abzman/1979-TI-thermostat-replacement-PCB/README.md

# 1979-TI-thermostat-replacement-PCB
replaces the PCB in an old thermostat with one that has an esp32 onboard and other upgrades
