abzman/1979-TI-thermostat-replacement-PCB/Board/TI thermostat esp32/TI thermostat esp32.kicad_pcb

## KiCad design Board/TI thermostat esp32/TI thermostat esp32.kicad_pcb (2022-02-09)

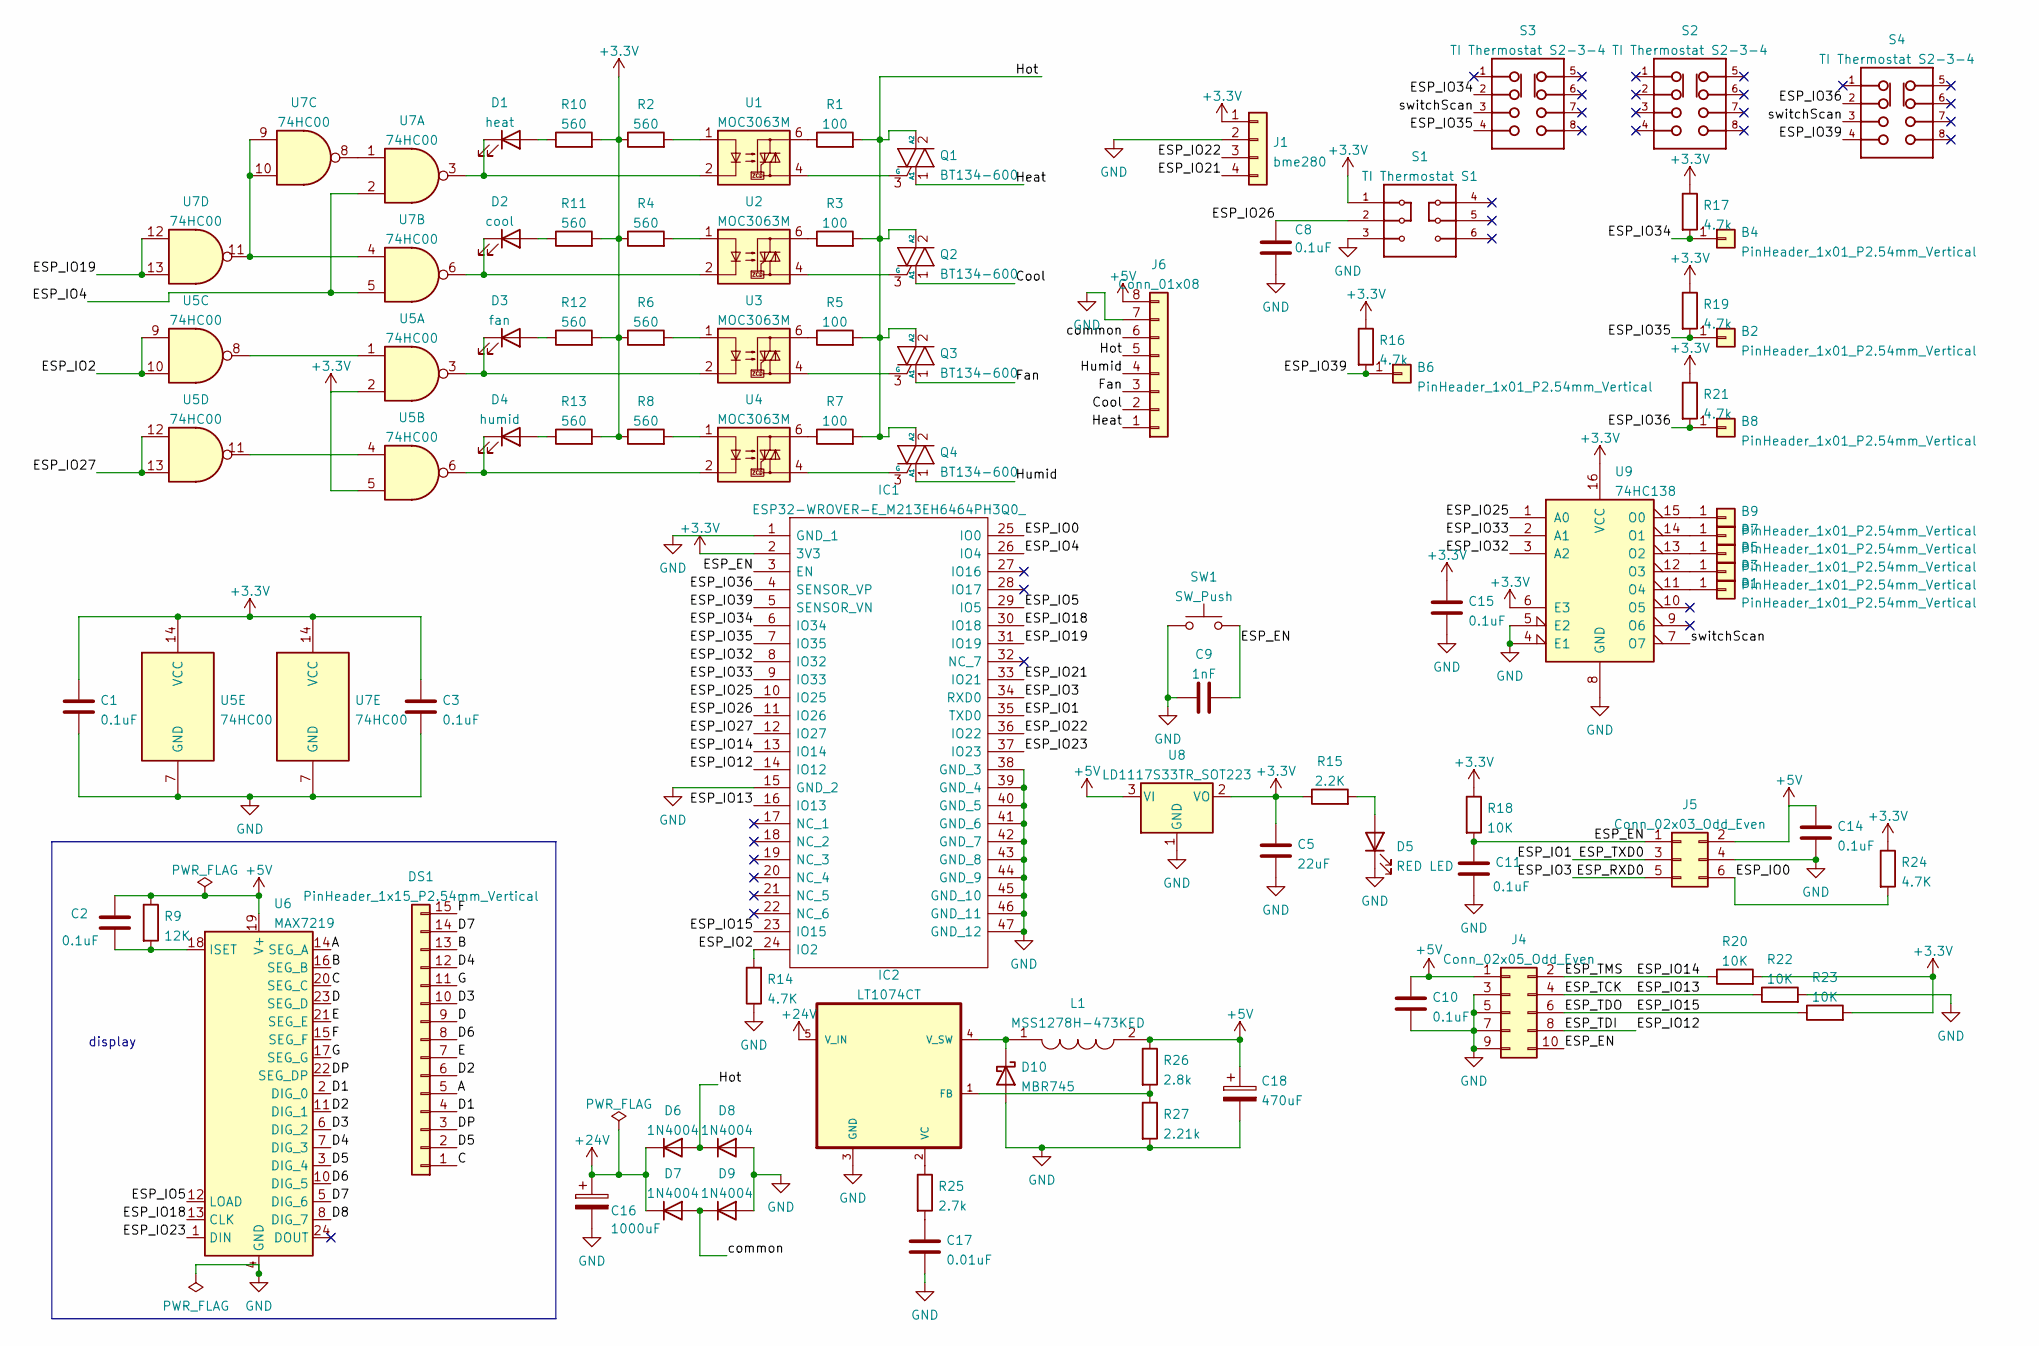
[picture p1: schematic TI thermostat esp32.kicad_sch]

Parts:
B1, B2, B3, B4, B5, B6, B7, B8, B9: PinHeader_1x01_P2.54mm_Vertical
C1, C2, C3, C8, C10, C11, C14, C15: 0.1uF; C_0603_1608Metric
C5: 22uF; CP_Radial_D5.0mm_P2.00mm
C9: 1nF; C_0603_1608Metric
C16: 1000uF; CP_Radial_D7.5mm_P2.50mm
C17: 0.01uF; C_0603_1608Metric
C18: 470uF; CP_Radial_D7.5mm_P2.50mm
D1: heat; LED_0603_1608Metric
D2: cool; LED_0603_1608Metric
D3: fan; LED_0603_1608Metric
D4: humid; LED_0603_1608Metric
D5: RED LED; LED_0603_1608Metric
D6, D7, D8, D9: 1N4004; D_SMA
D10: MBR745; TO-220-2_Horizontal_TabUp
DS1: PinHeader_1x15_P2.54mm_Vertical
IC1: ESP32-WROVER-E_M213EH6464PH3Q0_; ESP32WROVEREM213EH6464PH3Q0; Mouser Part Number 356-ESP32WRVE26464PC
IC2: LT1074CT; TO220_5L
J1: bme280; PinHeader_1x04_P2.54mm_Vertical
J4: Conn_02x05_Odd_Even; PinHeader_2x05_P2.54mm_Horizontal
J5: Conn_02x03_Odd_Even; PinHeader_2x03_P2.54mm_Horizontal
J6: Conn_01x08; PhoenixContact_MC_1,5_8-G-3.81_1x08_P3.81mm_Horizontal
L1: MSS1278H-473KED; INDPM120120X805N; Mouser Part Number 994-MSS1278H-473KED
Q1, Q2, Q3, Q4: BT134-600; TO-126-3_Horizontal_TabDown
R1, R3, R5, R7: 100; R_0603_1608Metric
R2, R4, R6, R8, R10, R11, R12, R13: 560; R_0603_1608Metric
R9: 12K; R_0603_1608Metric
R14, R24: 4.7K; R_0603_1608Metric
R15: 2.2K; R_0603_1608Metric
R16, R17, R19, R21: 4.7k; R_0603_1608Metric
R18, R20, R22, R23: 10K; R_0603_1608Metric
R25: 2.7k; R_0603_1608Metric
R26: 2.8k; R_0603_1608Metric
R27: 2.21k; R_0603_1608Metric
S1: TI Thermostat S1
S2, S3, S4: TI Thermostat S2-3-4
SW1: SW_Push; SW_Tactile_SPST_Angled_PTS645Vx39-2LFS
U1, U2, U3, U4: MOC3063M; DIP-6_W7.62mm
U5, U7: 74HC00; SOIC-14_3.9x8.7mm_P1.27mm
U6: MAX7219; SOP-24_7.5x15.4mm_P1.27mm
U8: LD1117S33TR_SOT223; SOT-223-3_TabPin2
U9: 74HC138; SOIC-16_3.9x9.9mm_P1.27mm

Connections:
+3V3: C1.1, C3.1, C5.1, C15.1, IC1.2 (3V3), J1.1, R2.1, R4.1, R6.1, R8.1, R10.2, R11.2, R12.2, R13.2, R15.1, R16.1, R17.1, R18.1, R19.1, R20.2, R21.1, R23.2, R24.1, S1.1, U5.2, U5.5, U5.14 (VCC), U7.14 (VCC), U8.2 (VO), U9.6 (E3), U9.16 (VCC)
+5V: C2.1, C10.1, C14.1, C18.1, J4.1, J5.2, J6.8, L1.2, R9.1, R26.1, U6.19 (V+), U8.3 (VI)
+24V: C16.1, D6.1 (K), D7.1 (K), IC2.5 (V_IN)
/A: DS1.5, U6.14 (SEG_A)
/B: DS1.13, U6.16 (SEG_B)
/C: DS1.1, U6.20 (SEG_C)
/Cool: J6.2, Q2.1 (A1)
/D: DS1.9, U6.23 (SEG_D)
/D1: DS1.4, U6.2 (DIG_0)
/D2: DS1.6, U6.11 (DIG_1)
/D3: DS1.10, U6.6 (DIG_2)
/D4: DS1.12, U6.7 (DIG_3)
/D5: DS1.2, U6.3 (DIG_4)
/D6: DS1.8, U6.10 (DIG_5)
/D7: DS1.14, U6.5 (DIG_6)
/D8: U6.8 (DIG_7)
/DP: DS1.3, U6.22 (SEG_DP)
/E: DS1.7, U6.21 (SEG_E)
/ESP_EN: C9.2, C11.1, IC1.3 (EN), J4.10, J5.1, R18.2, SW1.2
/ESP_IO0: IC1.25 (IO0), J5.6, R24.2
/ESP_IO1: IC1.35 (TXD0), J5.3
/ESP_IO2: IC1.24 (IO2), R14.2, U5.9, U5.10
/ESP_IO3: IC1.34 (RXD0), J5.5
/ESP_IO4: IC1.26 (IO4), U7.2, U7.5
/ESP_IO5: IC1.29 (IO5), U6.12 (LOAD)
/ESP_IO12: IC1.14 (IO12), J4.8
/ESP_IO13: IC1.16 (IO13), J4.4, R22.1
/ESP_IO14: IC1.13 (IO14), J4.2, R20.1
/ESP_IO15: IC1.23 (IO15), J4.6, R23.1
/ESP_IO18: IC1.30 (IO18), U6.13 (CLK)
/ESP_IO19: IC1.31 (IO19), U7.12, U7.13
/ESP_IO21: IC1.33 (IO21), J1.4
/ESP_IO22: IC1.36 (IO22), J1.3
/ESP_IO23: IC1.37 (IO23), U6.1 (DIN)
/ESP_IO25: IC1.10 (IO25), U9.1 (A0)
/ESP_IO26: C8.1, IC1.11 (IO26), S1.2
/ESP_IO27: IC1.12 (IO27), U5.12, U5.13
/ESP_IO32: IC1.8 (IO32), U9.3 (A2)
/ESP_IO33: IC1.9 (IO33), U9.2 (A1)
/ESP_IO34: B4.1, IC1.6 (IO34), R17.2, S3.2
/ESP_IO35: B2.1, IC1.7 (IO35), R19.2, S3.4
/ESP_IO36: B8.1, IC1.4 (SENSOR_VP), R21.2, S4.2
/ESP_IO39: B6.1, IC1.5 (SENSOR_VN), R16.2, S4.4
/F: DS1.15, U6.15 (SEG_F)
/Fan: J6.3, Q3.1 (A1)
/G: DS1.11, U6.17 (SEG_G)
/Heat: J6.1, Q1.1 (A1)
/Hot: D6.2 (A), D8.1 (K), J6.5, Q1.2 (A2), Q2.2 (A2), Q3.2 (A2), Q4.2 (A2), R1.2, R3.2, R5.2, R7.2
/Humid: J6.4, Q4.1 (A1)
/common: D7.2 (A), D9.1 (K), J6.6
/switchScan: S3.3, S4.3, U9.7 (O7)
GND: C1.2, C3.2, C5.2, C8.2, C9.1, C10.2, C11.2, C14.2, C15.2, C16.2, C17.2, C18.2, D5.1 (K), D8.2 (A), D9.2 (A), D10.2 (A), IC1.1 (GND_1), IC1.15 (GND_2), IC1.38 (GND_3), IC1.39 (GND_4), IC1.40 (GND_5), IC1.41 (GND_6), IC1.42 (GND_7), IC1.43 (GND_8), IC1.44 (GND_9), IC1.45 (GND_10), IC1.46 (GND_11), IC1.47 (GND_12), IC2.3 (GND), J1.2, J4.3, J4.5, J4.7, J4.9, J5.4, J6.7, R14.1, R22.2, R27.2, S1.3, SW1.1, U5.7 (GND), U6.4 (GND), U6.9 (GND), U7.7 (GND), U8.1 (GND), U9.4 (E1), U9.5 (E2), U9.8 (GND)
unnamed: B1.1, U9.11 (O4)
unnamed: B3.1, U9.12 (O3)
unnamed: B5.1, U9.13 (O2)
unnamed: B7.1, U9.14 (O1)
unnamed: B9.1, U9.15 (O0)
unnamed: C2.2, R9.2, U6.18 (ISET)
unnamed: C17.1, R25.2
unnamed: D1.1 (K), U1.2, U7.3
unnamed: D1.2 (A), R10.1
unnamed: D2.1 (K), U2.2, U7.6
unnamed: D2.2 (A), R11.1
unnamed: D3.1 (K), U3.2, U5.3
unnamed: D3.2 (A), R12.1
unnamed: D4.1 (K), U4.2, U5.6
unnamed: D4.2 (A), R13.1
unnamed: D5.2 (A), R15.2
unnamed: D10.1 (K), IC2.4 (V_SW), L1.1
unnamed: IC2.1 (FB), R26.2, R27.1
unnamed: IC2.2 (VC), R25.1
unnamed: Q1.3 (G), U1.4
unnamed: Q2.3 (G), U2.4
unnamed: Q3.3 (G), U3.4
unnamed: Q4.3 (G), U4.4
unnamed: R1.1, U1.6
unnamed: R2.2, U1.1
unnamed: R3.1, U2.6
unnamed: R4.2, U2.1
unnamed: R5.1, U3.6
unnamed: R6.2, U3.1
unnamed: R7.1, U4.6
unnamed: R8.2, U4.1
unnamed: U5.1, U5.8
unnamed: U5.4, U5.11
unnamed: U7.1, U7.8
unnamed: U7.4, U7.9, U7.10, U7.11

Notes on the sheet:
display

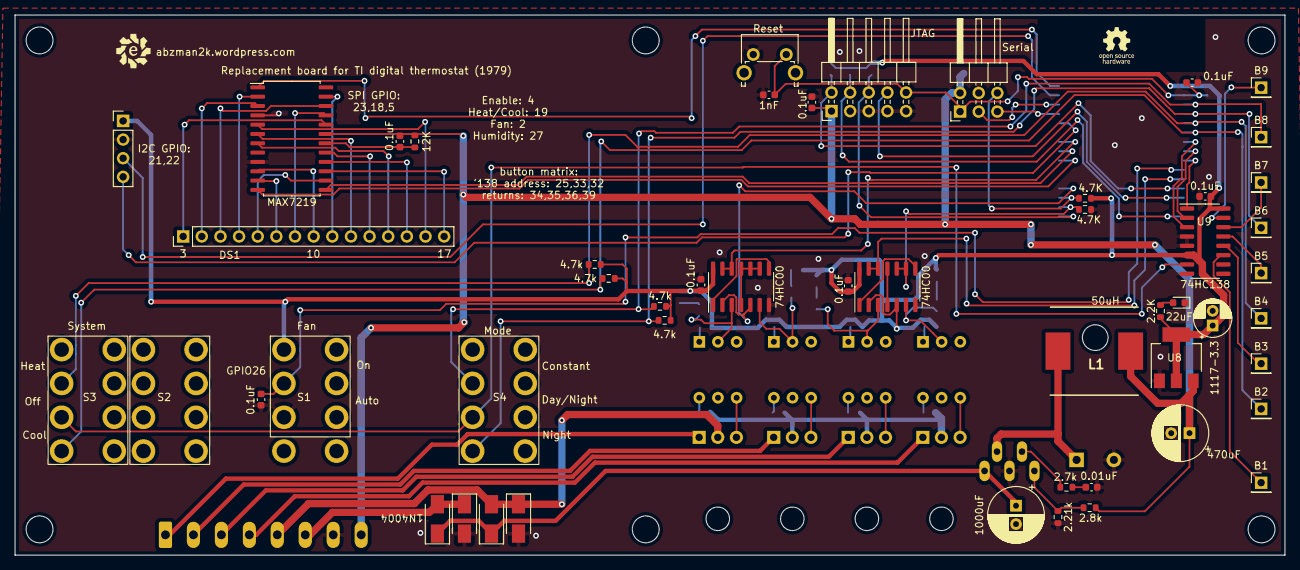
[picture p2: board TI thermostat esp32.kicad_pcb from above]

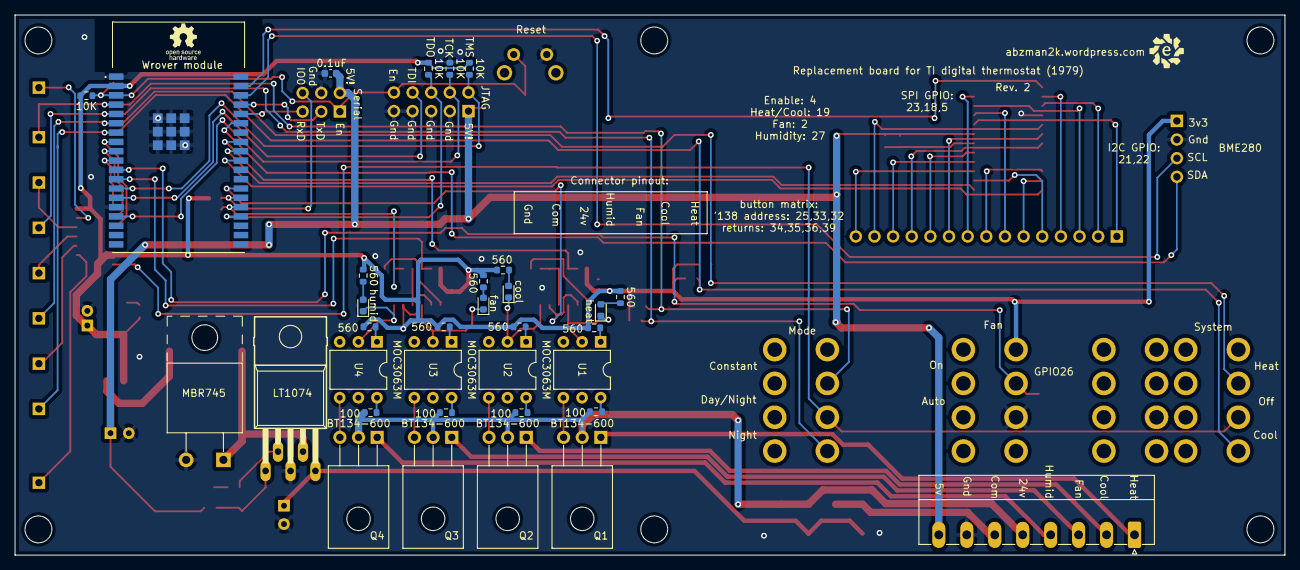
[picture p3: board TI thermostat esp32.kicad_pcb from below]

Board: 2 copper layers, 173.0 x 73.6 mm, 91 parts (33 on the bottom side), 86 nets.

Other parts of the board:
REF1, REF2, REF3, REF4, REF5, REF6: MountingHole_TI_Thermostat
