abzman/1979-TI-thermostat-replacement-PCB/original board/original board.kicad_sch

## KiCad design original board/original board.kicad_sch (2026-11-06)

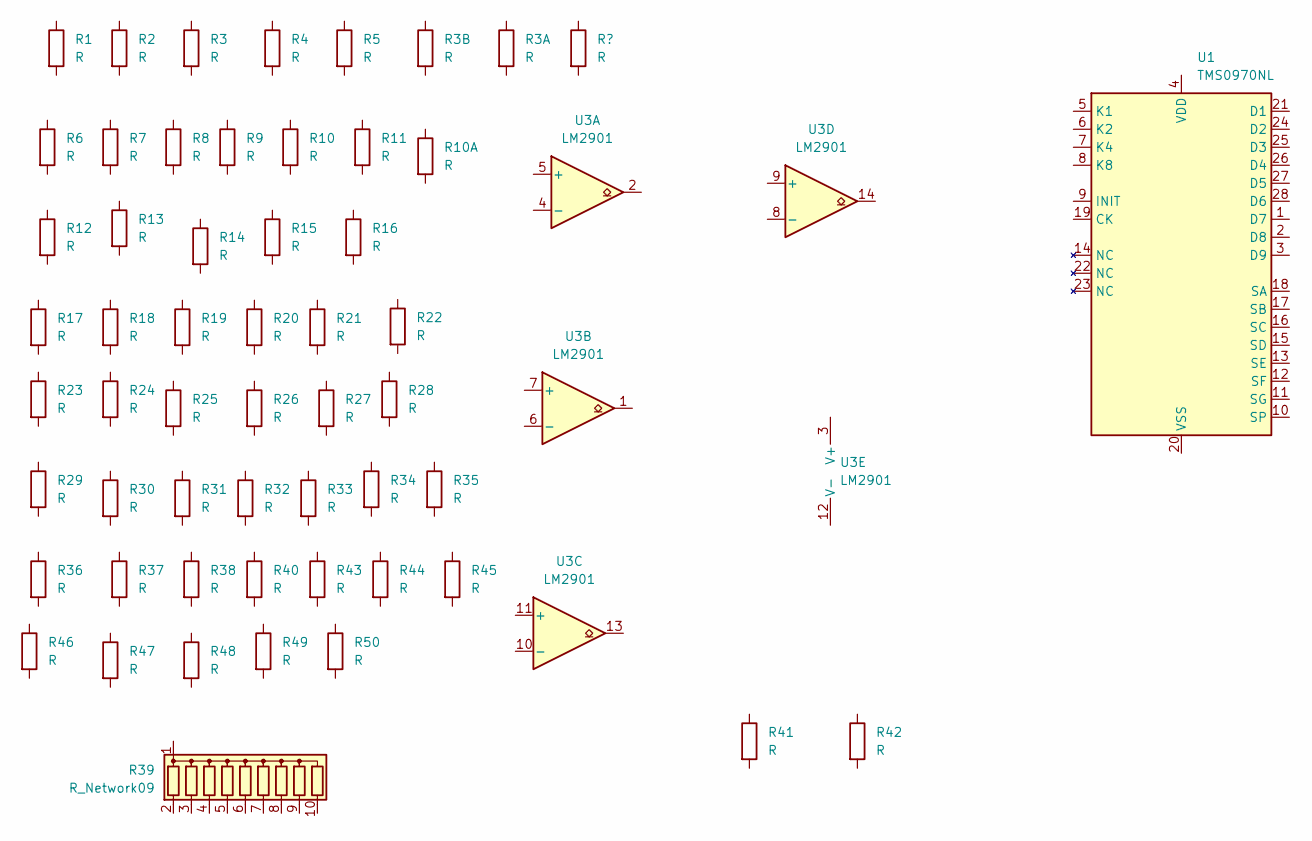
[picture p4: schematic original board.kicad_sch]

Parts:
R1, R2, R3, R3A, R3B, R4, R5, R6, R7, R8, R9, R10, R10A, R11, R12, R13, R14, R15, R16, R17, R18, R19, R20, R21, R22, R23, R24, R25, R26, R27, R28, R29, R30, R31, R32, R33, R34, R35, R36, R37, R38, R40, R41, R42, R43, R44, R45, R46, R47, R48, R49, R50: R
R39: R_Network09; R_Array_SIP10
U1: TMS0970NL; DIP-28S_W10.16mm_P1.778mm
U3: LM2901
