abzman/1979-TI-thermostat-replacement-PCB/(commit log)

2022-01-25 first commit (board rev1)
    [TI thermostat esp32-B_Cu.gbr, TI thermostat esp32-B_Mask.gbr, TI thermostat esp32-B_Paste.gbr, TI thermostat esp32-B_Silkscreen.gbr, TI thermostat esp32-Edge_Cuts.gbr, TI thermostat esp32-F_Cu.gbr, TI thermostat esp32-F_Mask.gbr, TI thermostat esp32-F_Paste.gbr]
2022-02-09 rev2 pcb and layout plus test code
    [TI thermostat esp32.kicad_pcb, TI thermostat esp32.kicad_sch]
2026-11-06 added original board tracing project
